ericwooshem/LavenderAir/VioletAir_AQI_Sensor_Bill_of_Materials.xlsx

Sheet: Intro
LavenderAir Air Quality Monitors
Bill of Materials
CC By-NC Brian & Eric Woo-Shem
Updated: 2022-12-12
Instructions:
1. Choose the sheet corresponding to the number of units you want to make. The options are 1 unit, 2-9 units, and >= 10 units
2. Change the number of units in the cell below "Enter number of sensors:" (A17) to match how many you want
3. Price and quantity cells will auto-populate
4. Purchase the number of packages (set of one or more parts sold together) on the vendor websites equal to the "QTY to Purchase" column (J)
Note that most of the other columns are for calculations and can be ignored.
The "Extra" column shows how many extra parts are left over for that number of sensors.
Note: For certain quantities, it can be less expensive to purchase parts for extra sensors because of bulk discounts
Open-Source PM/AQI Monitor. All written materials are licensed CC BY-NC. All code is available under the GNU GPL.
PurpleAir is a trademark of PurpleAir, Inc.
This project “LavenderAir” is a noncommercial, open-source project that seeks to replicate many features of the PurpleAir sensors. LavenderAir is in no way affiliated nor endorsed by PurpleAir, Inc., and LavenderAir components do not connect to nor interact with the PurpleAir network. LavenderAir monitors are “functional clones” built using off-the-shelf parts and no knowledge of commercial monitors aside from basic specifications made public on vendor websites. The creators of LavenderAir have no intention of any copyright or patent infringement, and to our best knowledge this project abides by all U.S. and international copyright laws.
The products shown in this Bill of Materials are examples for convenience only. LavenderAir has not tested all products shown, and listing here does not constitute an endorsement. Use your own judgment when purchasing. Prices may change over time.

Sheet: NanoPMM-SD Frugal
NanoPMM-SD Bill of Materials | Optimized for manufacture of 1 Unit, Frugal build – may require soldiering and using questionable suppliers |  |  |  |  |  |  |  |  |  | Prepared by Brian Woo-Shem and Eric Woo-Shem
Item | Vendor | Qty Included | Qty per Sensor | Product Cost | Sensor Cost | Per Part Cost | Req? | #Sens | QTY to Purchase | Extra | URL | Notes
Arduino Nano (Generic) | Ebay | 1 | 1 | $9.99 | $9.99 | $9.99 | 1 | 1 | 1 | 0 | www.ebay.com/itm/295147316536 | Microcontroller
Mini Breadboard | Ebay | 6 | 2 | $4.99 | $1.66 | $0.83 | 1 | 3 | 1 | 2 | /www.ebay.com/itm/122860010537 | Arduino pin base (avoid soldiering)
PMS5003 PM2.5 Air Quality Sensor & Breadboard Adapter | Ebay | 1 | 1 | $15.33 | $15.33 | $15.33 | 1 | 1 | 1 | 0 | www.ebay.com/itm/155117384193 | Sensor
DHT22 | Ebay | 1 | 1 | $1.68 | $1.68 | $1.68 | 1 | 1 | 1 | 0 | www.ebay.com/itm/125317208631
Micro SD Card Adapter Module + cables | Amazon | 5 | 1 | $6.99 | $1.40 | $1.40 | 1 | 5 | 1 | 4 | amzn.com/B08XPFYBYTB07BJ2P6X6 | Adapter for card recording sensor data and connects to computer to get logged data | Note no jumper wires because SD and RTC contain enough for 1 sensor
DS3231 Real Time Clock Module + Cables | Ebay | 1 | 1 | $1.83 | $1.83 | $1.83 | 1 | 1 | 1 | 0 | www.ebay.com/itm/133930020688 | Tracks time to correspond to data
CR2032 Battery | Ebay | 2 | 1 | $1.74 | $0.87 | $0.87 | 1 | 2 | 1 | 1 | www.ebay.com/itm/125243481815 | Power for Real Time Clock
Micro SD Memory Card | Amazon | 1 | 1 | $6.99 | $6.99 | $6.99 | 1 | 1 | 1 | 0 | www.amzn.com/B08XQ8V2QJ | Records sensor data and connects to computer to get logged data
USB Power Bank Battery 5V | Ebay | 5 | 1 | $5.29 | $1.06 | $1.06 | 0 | 5 | 1 | 4 | www.ebay.com/itm/192164254439 | Indicator light
Small Box | DIY | 1 | 1 | $0.00 | $0.00 | $0.00 | 0 | 1 | 1 | 0 |  | Housing to protect sensor and components. 3D print or build out of cardboard. May also cut holes in small (~12*10*4cm) cardboard box. Design may vary.
 |  |  | Cost Per Sensor |  | $40.81 |  |  |  |  |  |  | Complete Sensor
ENTER QTY |  |  | Cost of Required Components |  | $39.75 |  |  |  |  |  |  | Only the parts needed to get a barebones setup working off of a computer.
1
 |  |  | Total Cost |  | $54.83
 |  |  | Extra Part Value |  | $12.36

Sheet: NanoPMM-BT Beginner
NanoPMM-SD Bill of Materials | Optimized for manufacture of 1 Unit, avoiding any soldiering and using only two suppliers (Amazon + Adafruit) |  |  |  |  |  |  |  |  |  | Prepared by Brian Woo-Shem and Eric Woo-Shem
Item | Vendor | Qty Included | Qty per Sensor | Product Cost | Sensor Cost | Per Part Cost | Req? | #Sens | QTY to Purchase | Extra | URL | Notes
Arduino Nano (Generic) | Amazon | 1 | 1 | $12.99 | $12.99 | $12.99 | 1 | 1 | 1 | 0 | www.amzn,com/B07R9VWD39 | Microcontroller
Mini Breadboard | Amazon | 6 | 2 | $6.49 | $2.16 | $1.08 | 1 | 3 | 1 | 2 | www.amzn.com/B071KCZZ4K | Arduino pin base (avoid soldiering)
PMS5003 PM2.5 Air Quality Sensor & Breadboard Adapter | Adafruit | 1 | 1 | $39.95 | $39.95 | $39.95 | 1 | 1 | 1 | 0 | https://www.adafruit.com/product/3686 | Sensor
DHT22 Temperature & Humidity Sensor | Amazon | 2 | 1 | $9.99 | $5.00 | $5.00 | 1 | 2 | 1 | 1 | www.amzn.com/B09TKTWXH1
Bluetooth Module HC-05 | Amazon | 1 | 1 | $10.39 | $10.39 | $10.39 | 1 | 1 | 1 | 0 | www.amzn.com/B071YJG8DR | Transmit sensor data to computer
RGB LED | Amazon | 100 | 1 | $7.98 | $0.08 | $0.08 | 0 | 100 | 1 | 99 | www.amzn.com/B0194Y6MW2 | Indicator light. Unfortunately no good way to get just 1
Small Box | DIY | 1 | 1 | $0.00 | $0.00 | $0.00 | 0 | 1 | 1 | 0 |  | Housing to protect sensor and components. 3D print or build out of cardboard. May also cut holes in small (~12*10*4cm) cardboard box. Design may vary.
 |  |  | Cost Per Sensor |  | $70.57 |  |  |  |  |  |  | Complete Sensor
ENTER QTY
1
 |  |  | Total Cost |  | $87.79
 |  |  | Extra Part Value |  | $15.06

Sheet: NanoPMM-DISP Beginner
NanoPMM-SD Bill of Materials | Optimized for manufacture of 1 Unit, avoiding any soldiering and using only two suppliers (Amazon + Adafruit) |  |  |  |  |  |  |  |  |  | Prepared by Brian Woo-Shem and Eric Woo-Shem
Item | Vendor | Qty Included | Qty per Sensor | Product Cost | Sensor Cost | Per Part Cost | Req? | #Sens | QTY to Purchase | Extra | URL | Notes
Arduino Nano (Generic) | Amazon | 1 | 1 | $12.99 | $12.99 | $12.99 | 1 | 1 | 1 | 0 | www.amzn,com/B07R9VWD39 | Microcontroller
Mini Breadboard | Amazon | 6 | 2 | $6.49 | $2.16 | $1.08 | 1 | 3 | 1 | 2 | www.amzn.com/B071KCZZ4K | Arduino pin base (avoid soldiering)
PMS5003 PM2.5 Air Quality Sensor & Breadboard Adapter | Adafruit | 1 | 1 | $39.95 | $39.95 | $39.95 | 1 | 1 | 1 | 0 | https://www.adafruit.com/product/3686 | Sensor
DHT22 Temperature & Humidity Sensor | Amazon | 2 | 1 | $9.99 | $5.00 | $5.00 | 1 | 2 | 1 | 1 | www.amzn.com/B09TKTWXH1
DS3231 Real Time Clock Module + Cables | Amazon | 2 | 1 | $9.99 | $5.00 | $5.00 | 1 | 2 | 1 | 1 | www.amzn.com/B09LLMYBM1 | Tracks time to correspond to data
CR2032 Battery (Included with ^) | ^ | 2 | 1 | $0.00 | $0.00 | $0.00 | 1 | 2 | 1 | 1 |  | Power for Real Time Clock
I2C 1602 LCD Display | Amazon | 2 | 1 | $10.99 | $5.50 | $5.50 | 0 | 2 | 1 | 1 | www.amzn.com/B07S7PJYM6 | LCD Display
Small Box | DIY | 1 | 1 | $0.00 | $0.00 | $0.00 | 0 | 1 | 1 | 0 |  | Housing to protect sensor and components. 3D print or build out of cardboard. May also cut holes in small (~12*10*4cm) cardboard box. Design may vary.
 |  |  | Cost Per Sensor |  | $70.59 |  |  |  |  |  |  | Complete Sensor
ENTER QTY |  |  | Cost of Required Components |  | $65.09 |  |  |  |  |  |  | Only the parts needed to get a barebones setup working off of a computer.
1
 |  |  | Total Cost |  | $90.40
 |  |  | Extra Part Value |  | $17.65

Sheet: MegaPMM Beginner
NanoPMM-SD Bill of Materials | Optimized for manufacture of 1 Unit, avoiding any soldiering and using only two suppliers (Amazon + Adafruit) |  |  |  |  |  |  |  |  |  | Prepared by Brian Woo-Shem and Eric Woo-Shem
Item | Vendor | Qty Included | Qty per Sensor | Product Cost | Sensor Cost | Per Part Cost | Req? | #Sens | QTY to Purchase | Extra | URL | Notes
Arduino Mega (Generic) | Amazon | 1 | 1 | $20.99 | $20.99 | $20.99 | 1 | 1 | 1 | 0 | www.amzn,com/B01H4ZLZLQ | Microcontroller
Mini Breadboard | Amazon | 6 | 2 | $6.49 | $2.16 | $1.08 | 1 | 3 | 1 | 2 | www.amzn.com/B071KCZZ4K | Arduino pin base (avoid soldiering)
PMS5003 PM2.5 Air Quality Sensor & Breadboard Adapter | Adafruit | 1 | 2 | $39.95 | $79.90 | $39.95 | 1 | 0.5 | 2 | 0 | https://www.adafruit.com/product/3686 | Sensor
DHT22 Temperature & Humidity Sensor | Amazon | 2 | 1 | $9.99 | $5.00 | $5.00 | 1 | 2 | 1 | 1 | www.amzn.com/B09TKTWXH1
Micro SD Card Adapter Module + cables | Amazon | 3 | 1 | $6.99 | $2.33 | $2.33 | 1 | 3 | 1 | 2 | amzn.com/B08XPFYBYTB07BJ2P6X | Adapter for card recording sensor data and connects to computer to get logged data | Note no jumper wires because SD and RTC contain enough for 1 sensor
DS3231 Real Time Clock Module + Cables | Amazon | 2 | 1 | $9.99 | $5.00 | $5.00 | 1 | 2 | 1 | 1 | www.amzn.com/B09LLMYBM1 | Tracks time to correspond to data
CR2032 Battery (Included with ^) | ^ | 2 | 1 | $0.00 | $0.00 | $0.00 | 1 | 2 | 1 | 1 |  | Power for Real Time Clock
Micro SD Memory Card | Amazon | 1 | 1 | $6.99 | $6.99 | $6.99 | 1 | 1 | 1 | 0 | www.amzn.com/B08XQ8V2QJ | Records sensor data and connects to computer to get logged data
Bluetooth Module HC-05 | Amazon | 1 | 1 | $10.39 | $10.39 | $10.39 | 1 | 1 | 1 | 1 | www.amzn.com/B071YJG8DR | Transmit sensor data to computer
I2C 1602 LCD Display | Amazon | 2 | 1 | $10.99 | $5.50 | $5.50 | 0 | 2 | 1 | 2 | www.amzn.com/B07S7PJYM6 | LCD Display
RGB LED | Amazon | 100 | 1 | $7.98 | $0.08 | $0.08 | 0 | 100 | 1 | 99 | www.amzn.com/B0194Y6MW2 | Indicator light. Unfortunately no good way to get just 1
Jumper Wires Set | Amazon | 120 | 40 | $6.98 | $2.33 | $0.06 | 0 | 3 | 1 | 2 | www.amzn.com/B01EV70C78
Small Box | DIY | 1 | 1 | $0.00 | $0.00 | $0.00 | 0 | 1 | 1 | 0 |  | Housing to protect sensor and components. 3D print or build out of cardboard. May also cut holes in small (~12*10*4cm) cardboard box. Design may vary.
 |  |  | Cost Per Sensor |  | $140.65 |  |  |  |  |  |  | Complete Sensor
ENTER QTY
1
 |  |  | Total Cost |  | $177.68
 |  |  | Extra Part Value |  | $46.21
