ericwooshem/LavenderAir/(commit log)

2022-12-14 Compare Sensors
2022-12-14 Compare devices v2
