ericwooshem/LavenderAir/(notices)

Notices in the files:
LavenderAir_NanoPMM-Disp_V1-00/LavenderAir_NanoPMM-Disp_V1-00.ino:
This program is free software: you can redistribute it and/or modify it under the terms of the
GNU General Public License version 3 as published by the Free Software Foundation.
